phretor/valentine-card-compound-machine/3d/r2d2-servo-driven-hinge/README.txt

R2D2 - Servo Driven Hinge Design by FleX_101 on Thingiverse: https://www.thingiverse.com/thing:1323380
