phretor/valentine-card-compound-machine/3d/r2d2-servo-driven-hinge/images/00e0f12dadee065d589ce82db6d3d95c.png

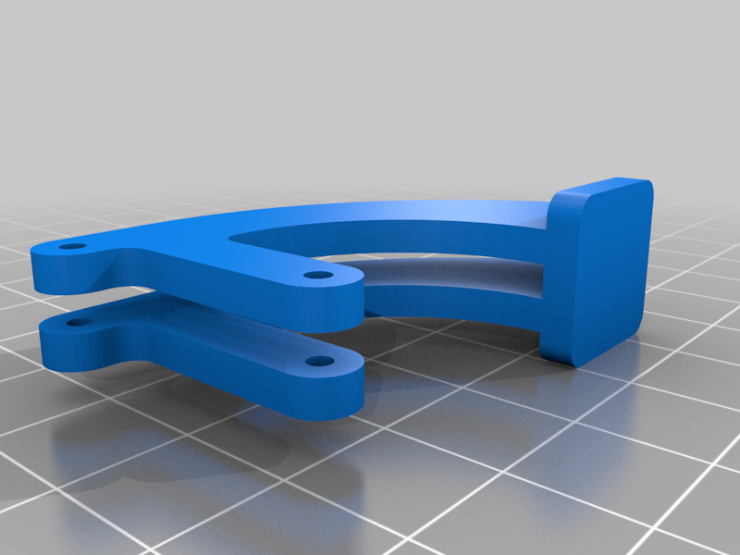
3d/r2d2-servo-driven-hinge/images/00e0f12dadee065d589ce82db6d3d95c.png
