phretor/valentine-card-compound-machine/3d/r2d2-servo-driven-hinge/images/1d6e59405a0414b763c436d95ff33d13.png

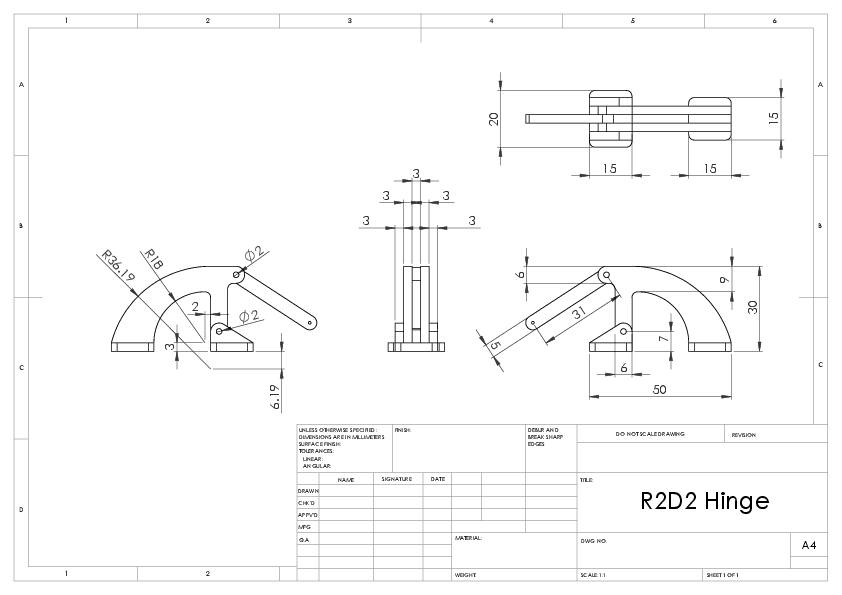
3d/r2d2-servo-driven-hinge/images/1d6e59405a0414b763c436d95ff33d13.png
