phretor/valentine-card-compound-machine/3d/r2d2-servo-driven-hinge/images/209ce7e4dcc8de5a14c967e012307415.png

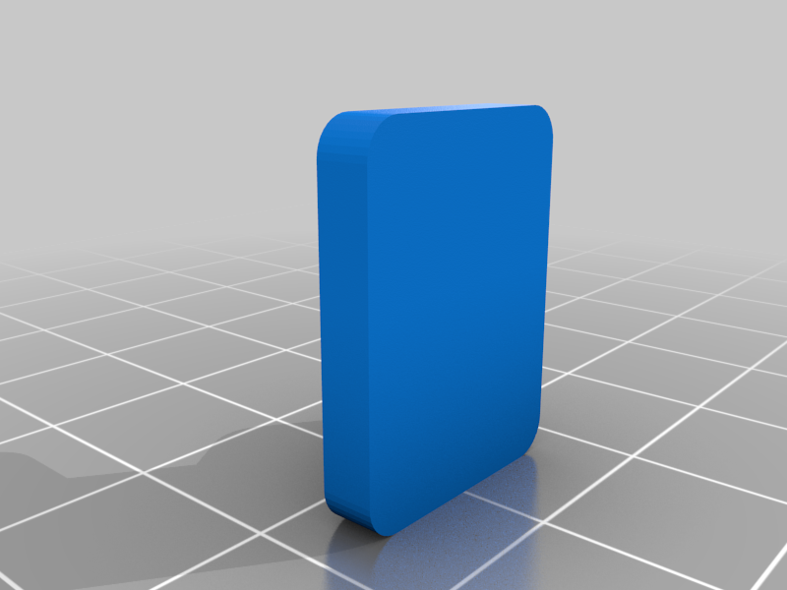
3d/r2d2-servo-driven-hinge/images/209ce7e4dcc8de5a14c967e012307415.png
