phretor/valentine-card-compound-machine/3d/r2d2-servo-driven-hinge/images/ac2de3e5b3c30d6cfa2b8d253222a62f.png

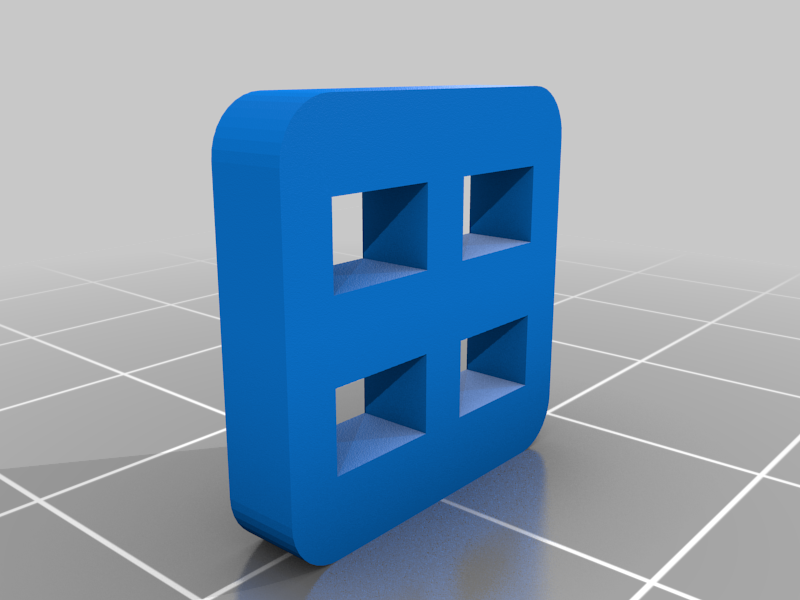
3d/r2d2-servo-driven-hinge/images/ac2de3e5b3c30d6cfa2b8d253222a62f.png
