phretor/valentine-card-compound-machine/3d/r2d2-servo-driven-hinge/images/b55bf41fc63e45db93ab5a4a662c3390.png

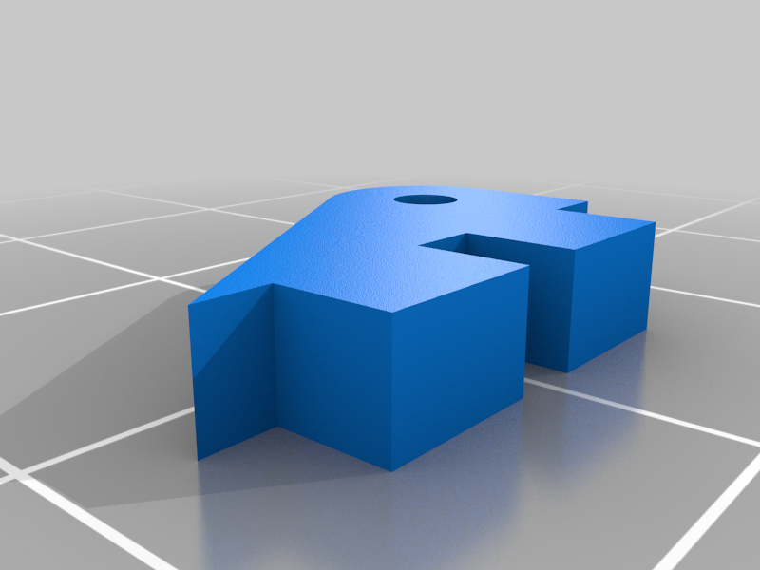
3d/r2d2-servo-driven-hinge/images/b55bf41fc63e45db93ab5a4a662c3390.png
