phretor/valentine-card-compound-machine/3d/r2d2-servo-driven-hinge/images/b84e767623b3af9428519e8bac68a532.png

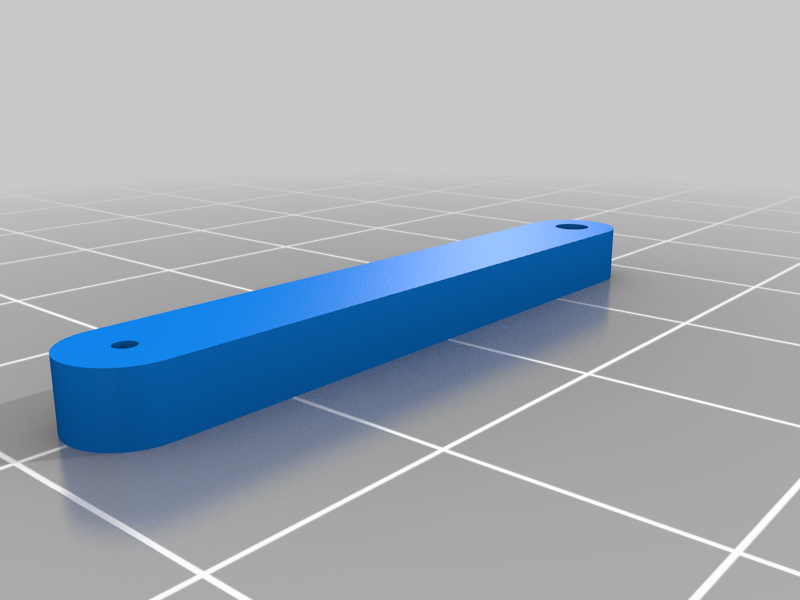
3d/r2d2-servo-driven-hinge/images/b84e767623b3af9428519e8bac68a532.png
