phretor/valentine-card-compound-machine/3d/r2d2-servo-driven-hinge/images/daca9755d2fd17f31569f609cff751e9.png

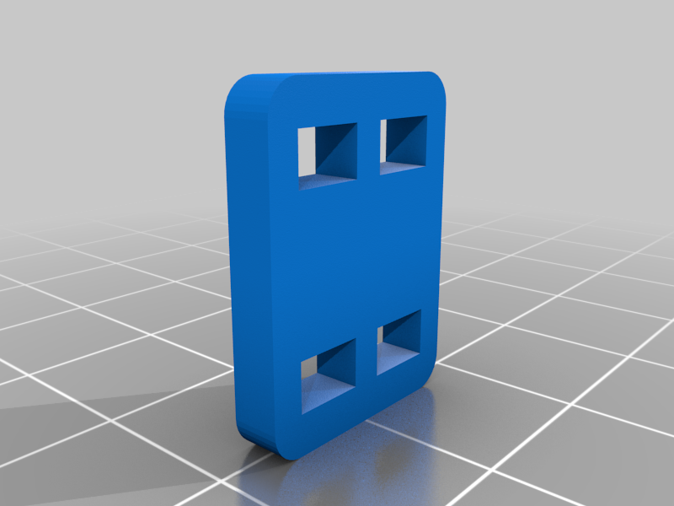
3d/r2d2-servo-driven-hinge/images/daca9755d2fd17f31569f609cff751e9.png
