phretor/valentine-card-compound-machine/3d/r2d2-servo-driven-hinge/images/ea4d65a4fa880a1a4c161aa4b0633bdc.png

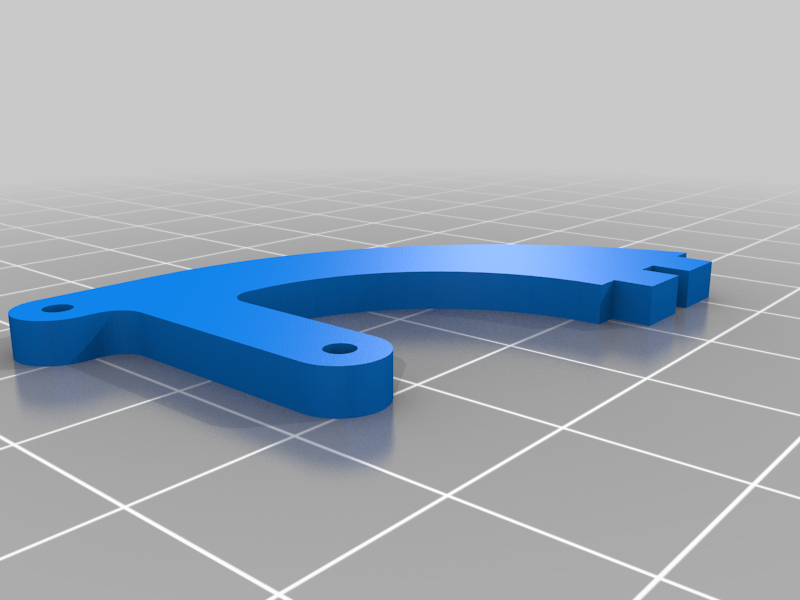
3d/r2d2-servo-driven-hinge/images/ea4d65a4fa880a1a4c161aa4b0633bdc.png
