phretor/valentine-card-compound-machine/3d/r2d2-servo-driven-hinge/files/Horn_Single_Piece.STL

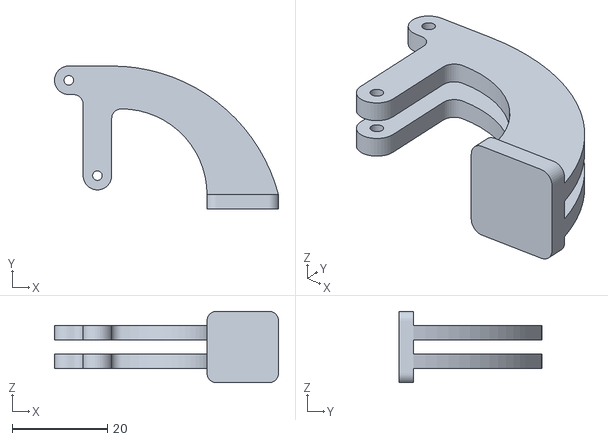
[picture p19: CAD file, 2026-10-24]
3d/r2d2-servo-driven-hinge/files/Horn_Single_Piece.STL
47.0 x 30.0 x 15.0
