phretor/valentine-card-compound-machine/3d/r2d2-servo-driven-hinge/files/Hinge_Single_Piece.STL

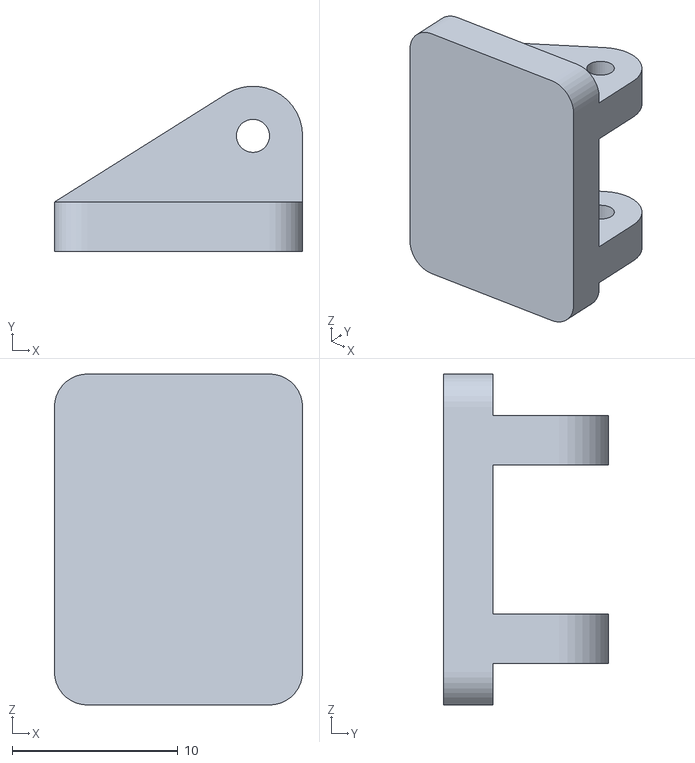
[picture p20: CAD file, 2026-10-24]
3d/r2d2-servo-driven-hinge/files/Hinge_Single_Piece.STL
15.0 x 9.99 x 20.0
