phretor/valentine-card-compound-machine/(list of files, drawings)

Other design files:
schematics/vmac.fzz
